jekyll2014/BTStation/docs/case_3d/image3.jpg

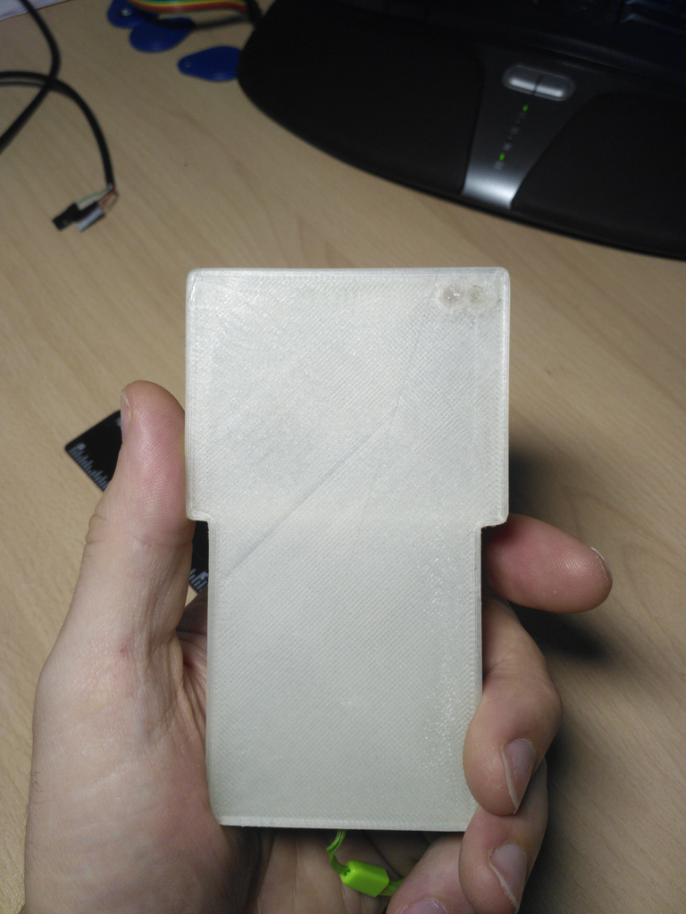
docs/case_3d/image3.jpg
