jekyll2014/BTStation/test_fw/README.md

Судейские Bluetooth станции электронной отметки для ММБ. [Исходная разработка](https://github.com/alexandervolikov/bt_station_mmb) - @alexandervolikov.

ТЗ на разработку судейских станций [здесь](docs/README.md).

Обычные станции без Bluetooth [здесь](https://github.com/alexandervolikov/sportiduino).
