jekyll2014/BTStation/docs/bluetooth/bt04-a/s01231336 (1).jpg

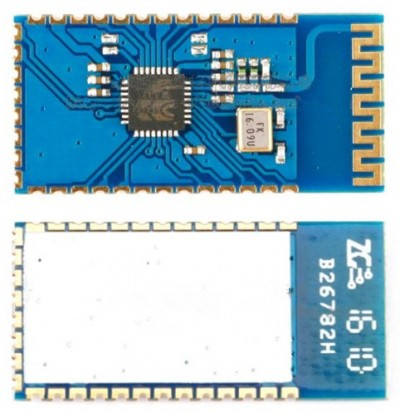
docs/bluetooth/bt04-a/s01231336 (1).jpg
