jekyll2014/BTStation/docs/bluetooth/bt04-a/s15476322.jpg

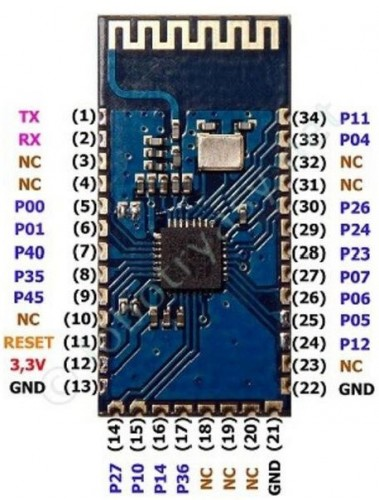
docs/bluetooth/bt04-a/s15476322.jpg
