jekyll2014/BTStation/docs/bluetooth/bt04-a/s88235175.jpg

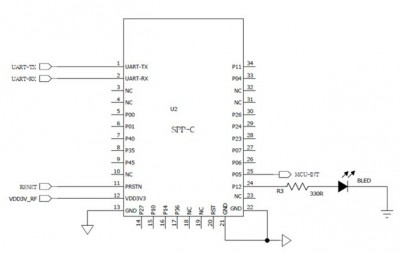
docs/bluetooth/bt04-a/s88235175.jpg
