jekyll2014/BTStation/docs/case_3d/image1.jpg

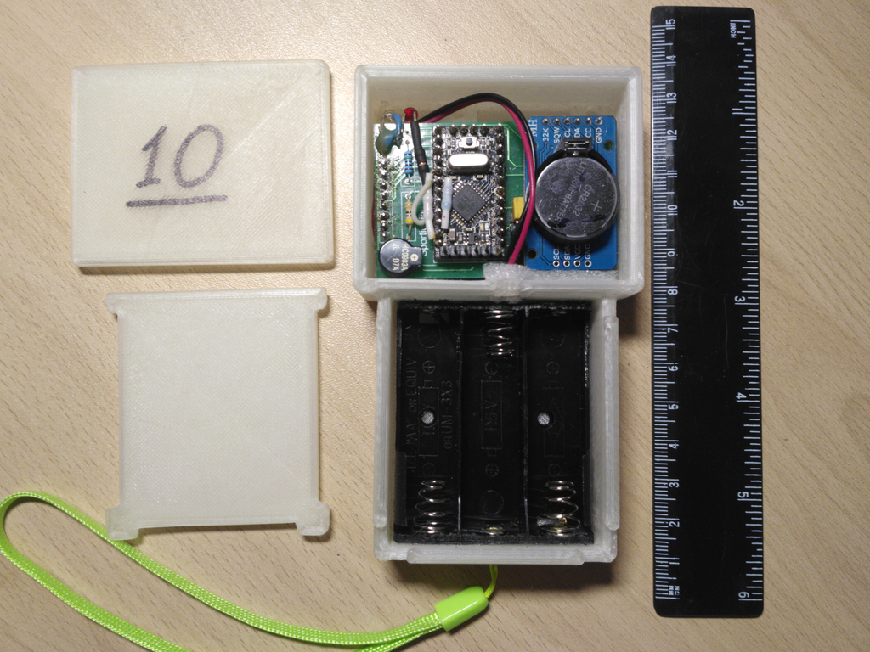
docs/case_3d/image1.jpg
