jekyll2014/BTStation/docs/case_3d/image2.jpg

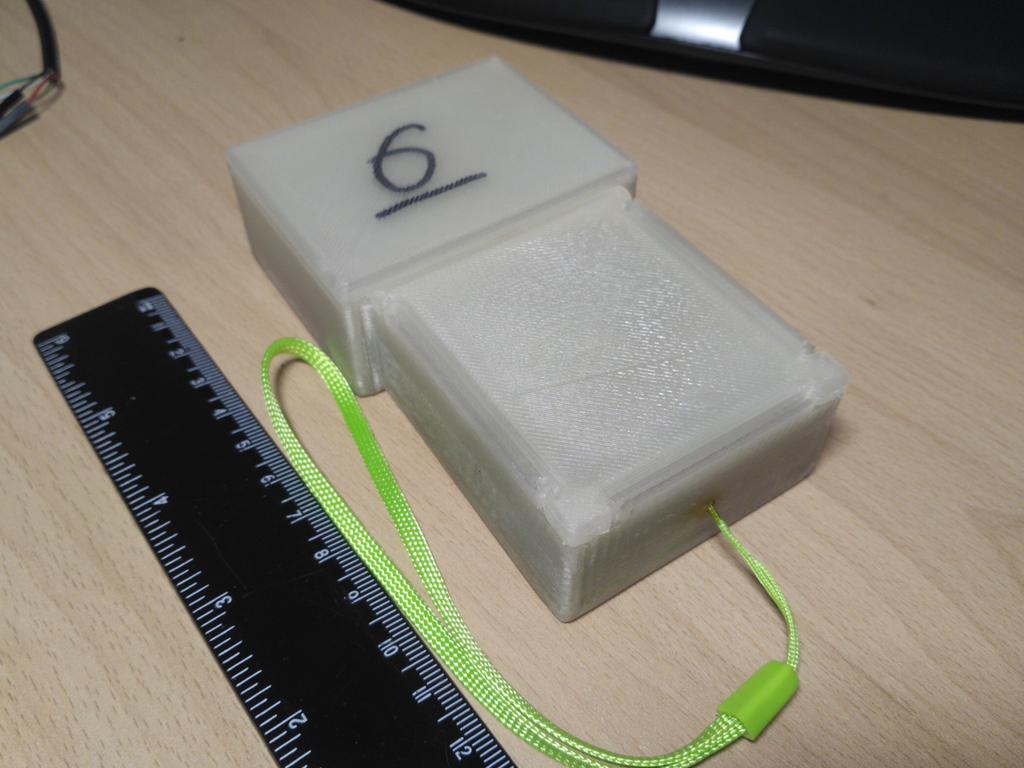
docs/case_3d/image2.jpg
