jekyll2014/BTStation/docs/case_3d/rfid_box_v3.jpg

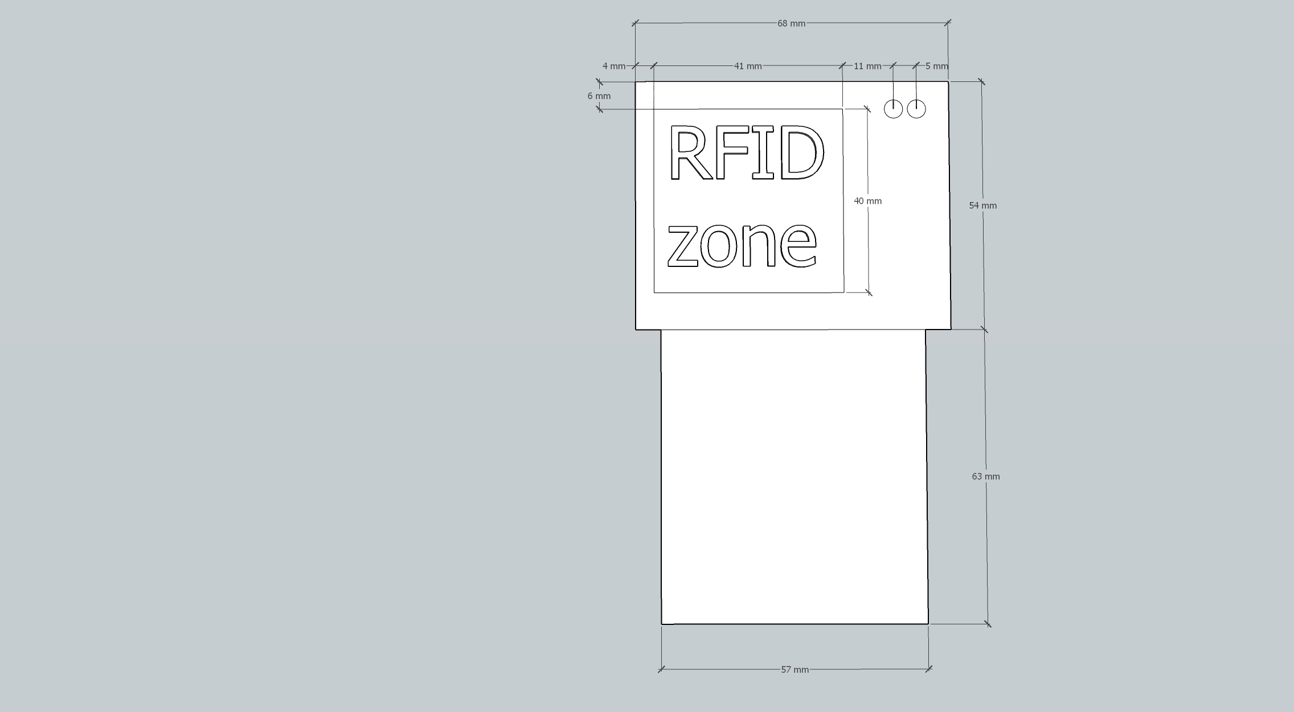
docs/case_3d/rfid_box_v3.jpg
