jekyll2014/BTStation/docs/rfid/RFID-RC522.png

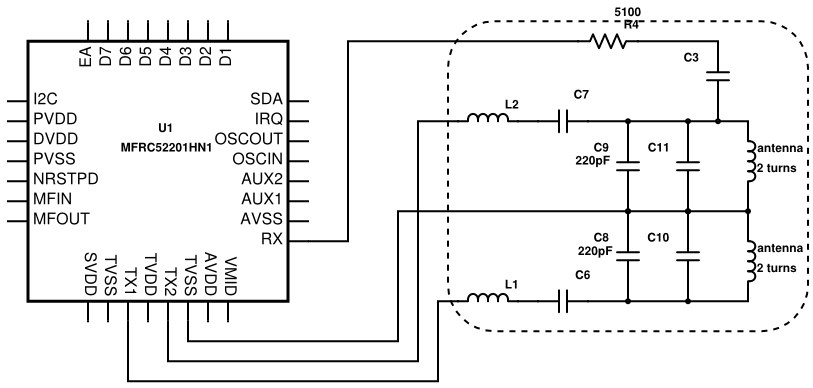
docs/rfid/RFID-RC522.png
