jekyll2014/BTStation/docs/case_3d/v3/rfid_box_v3-1_box.stl

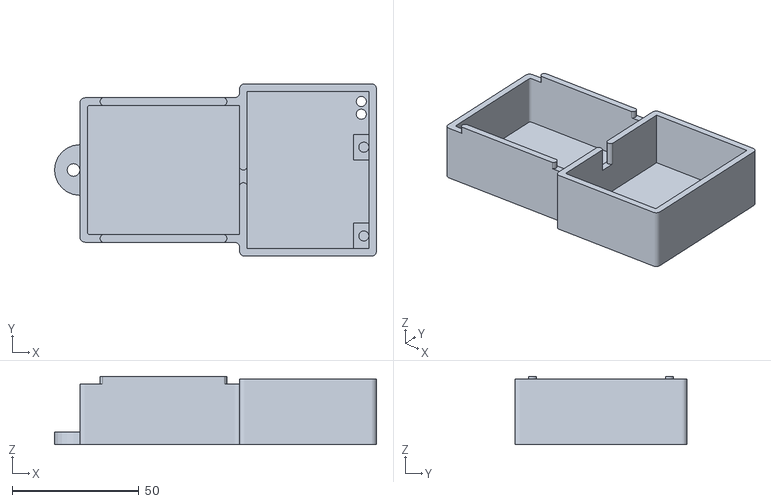
[picture p20: CAD file, 2020-05-06]
docs/case_3d/v3/rfid_box_v3-1_box.stl
127.0 x 68.0 x 27.0
