jekyll2014/BTStation/docs/case_3d/v3/rfid_box_v3-4_plug.stl

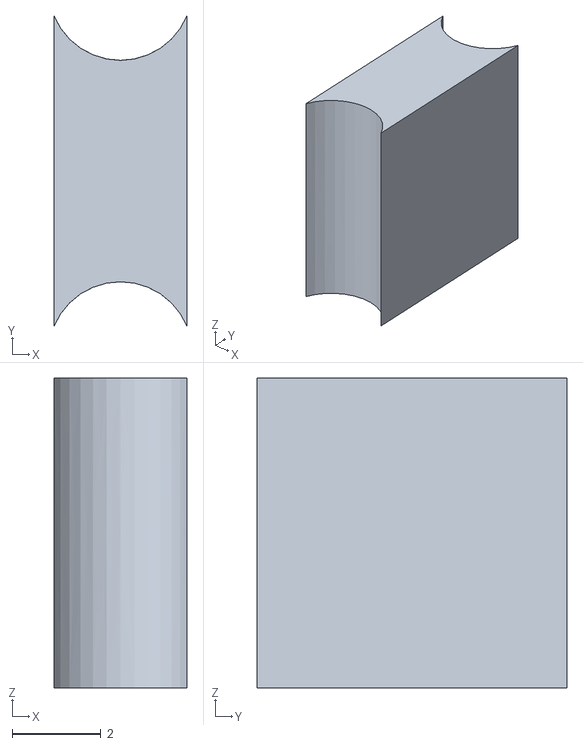
[picture p21: CAD file, 2020-05-06]
docs/case_3d/v3/rfid_box_v3-4_plug.stl
3.00 x 7.00 x 7.00
