jekyll2014/BTStation/docs/case_3d/v3/rfid_box_v3-3_battery.stl

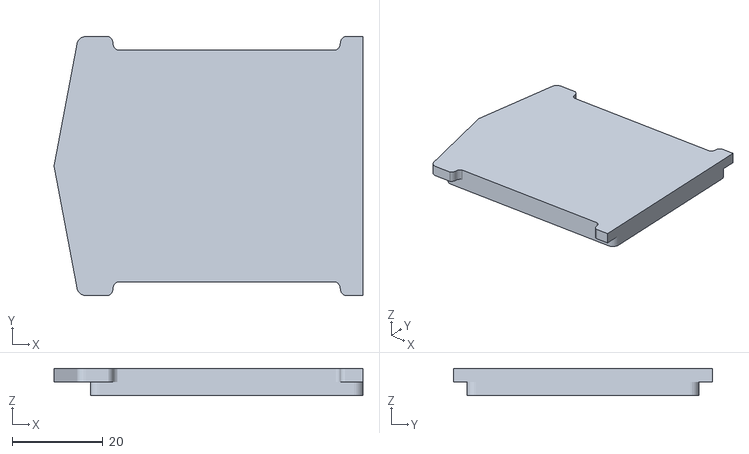
[picture p22: CAD file, 2020-05-06]
docs/case_3d/v3/rfid_box_v3-3_battery.stl
68.0 x 57.0 x 6.00
