jekyll2014/BTStation/docs/case_3d/v3/rfid_box_v3-2_rfid.stl

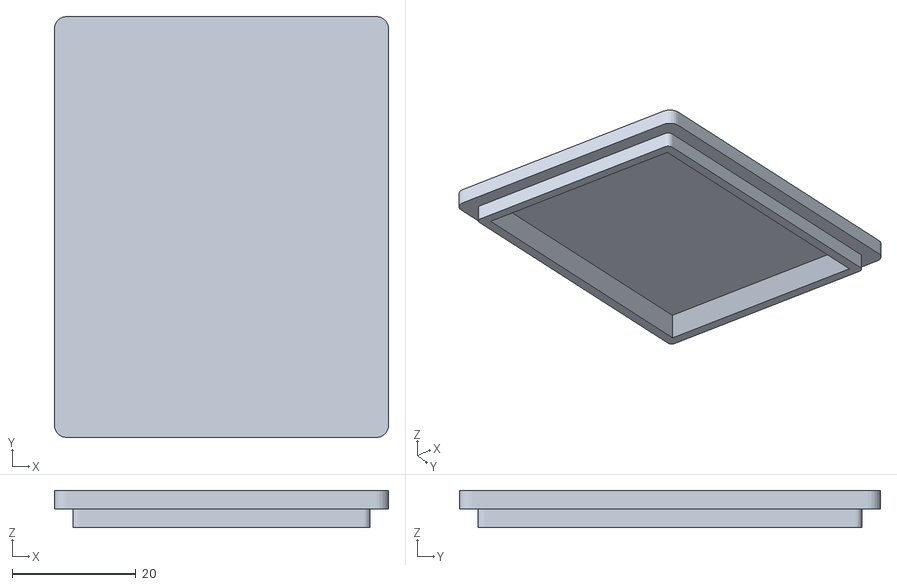
[picture p23: CAD file, 2020-05-06]
docs/case_3d/v3/rfid_box_v3-2_rfid.stl
54.0 x 68.0 x 6.00
