jekyll2014/BTStation/docs/case_3d/v1/rfid_box-3.stl

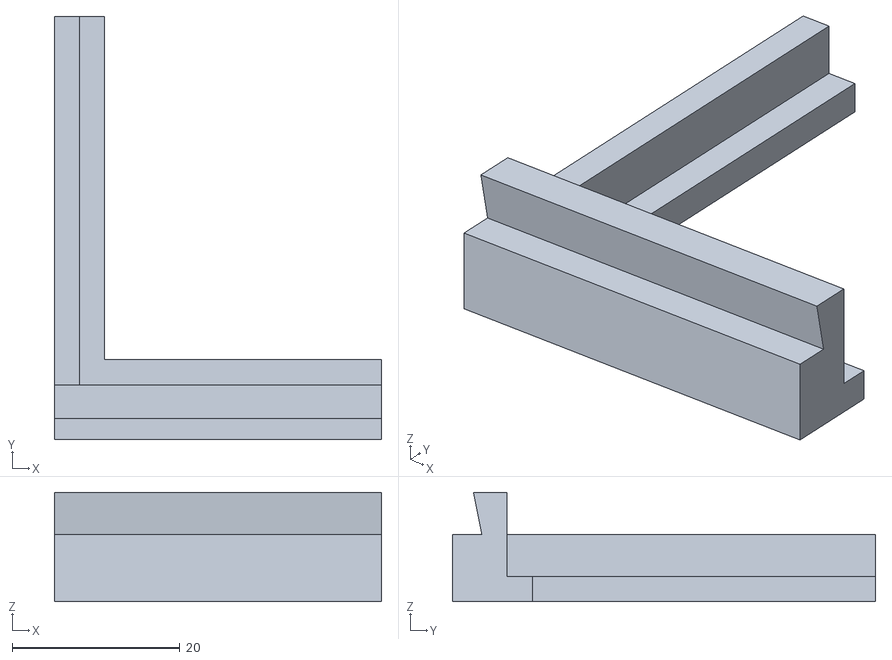
[picture p24: CAD file, 2020-05-06, an earlier design]
docs/case_3d/v1/rfid_box-3.stl
39.0 x 50.4 x 13.0
