jekyll2014/BTStation/docs/case_3d/v2/rfid_box_v2-1.stl

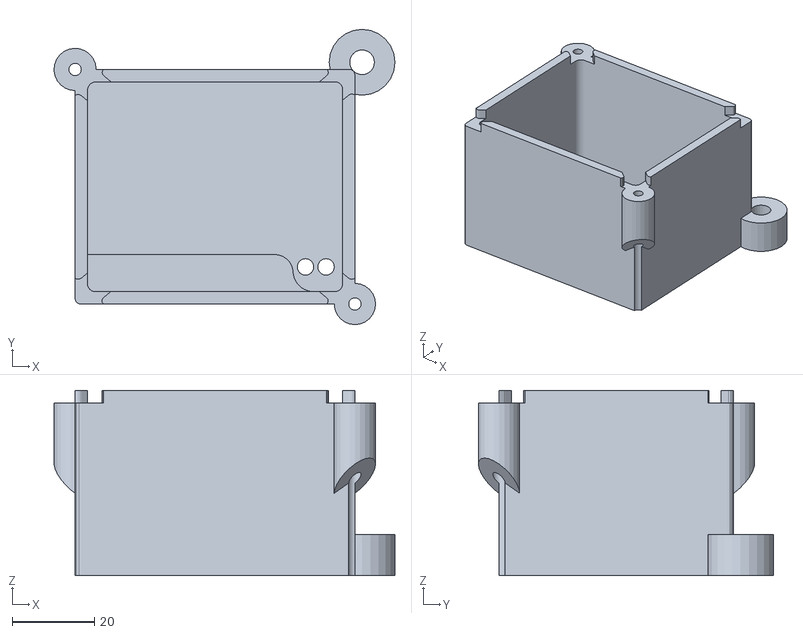
[picture p25: CAD file, 2020-05-06, an earlier design]
docs/case_3d/v2/rfid_box_v2-1.stl
82.9 x 71.8 x 45.0
