jekyll2014/BTStation/docs/case_3d/v1/rfid_box-2.stl

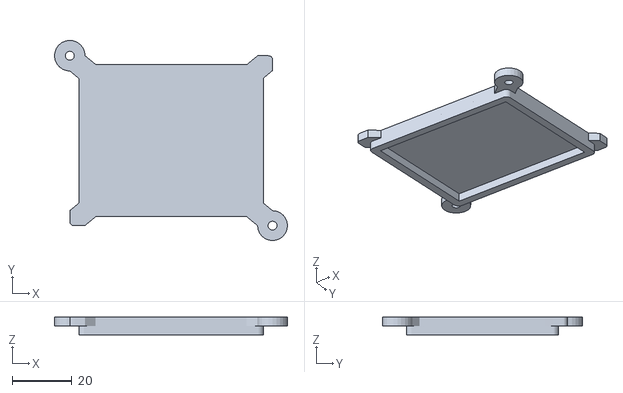
[picture p26: CAD file, 2020-05-06, an earlier design]
docs/case_3d/v1/rfid_box-2.stl
78.2 x 67.2 x 6.00
