jekyll2014/BTStation/docs/case_3d/v2/rfid_box_v2-2.stl

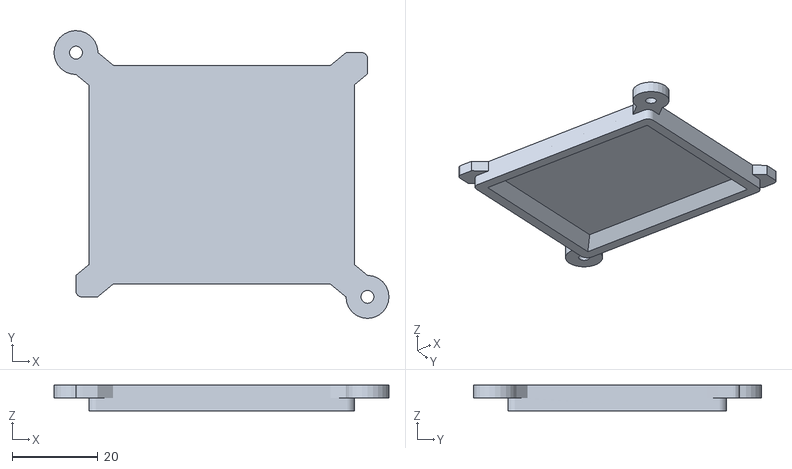
[picture p27: CAD file, 2020-05-06, an earlier design]
docs/case_3d/v2/rfid_box_v2-2.stl
78.2 x 67.2 x 6.00
