jekyll2014/BTStation/docs/case_3d/v1/rfid_box-1.stl

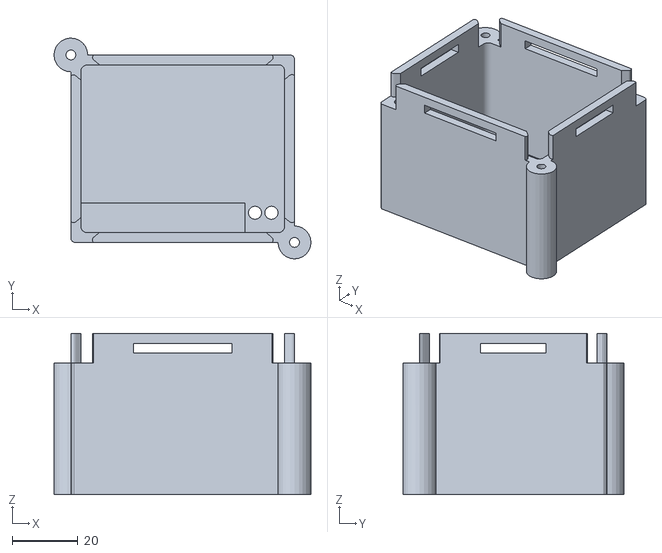
[picture p28: CAD file, 2020-05-06, an earlier design]
docs/case_3d/v1/rfid_box-1.stl
78.2 x 67.2 x 49.0
