jekyll2014/BTStation/(list of files, cad)

Other CAD files:
docs/case_3d/v2/rfid_box_v2-3.stl
docs/case_3d/v1/rfid_box.skp
docs/case_3d/v2/rfid_box_v2.skp
docs/case_3d/v3/rfid_box_v3.skp
