jekyll2014/BTStation/docs/issues.txt

To do:
fw	8) сделать бинарный поиск последнего занятого блока на карточке

+fw	1) доделать перезапись флэша для финишного режима.
+fw	2) в протокол ввести доп.параметр "ID запроса" (вместо 3-го 0xfe)
	- этот номер генерить при отправке команды и при отправке ответа станция будет этот номер оставлять в пакете.
+fw	3) поправить алгоритм смены маски команды (отметка схода участника)
	- новая маска хранится в памяти и обновляется при обработке карточки
	- после записи новой маски в карточку очищать буфер новой маски.
+fw	4) проверять версию прошивки при работе с чипами
+fw	5) запись в чип writeCardPage() разрешать только по UID
	- initChip() не требует UID, а возвращает его
+fw	6) предупреждать оператора о падении напряжения ниже критического (3.3V ?)
  	- мигать красным, пищать
+fw	7) продумать систему сигнализации об ошибках
	- синий светодиод горит во время работы с карточкой и показает по завершению.
  	- короткий писк (<0.5 сек.) раздается при окончании работы.
  	- любая ошибка - длинный писк 2 секунды + красный светодиод.
	- разделить ошибки на классы по типу оборудования:
		RFID - 1 сигнал
		Flash - 2 сигнала
		UART - 3 сигнала
		Прочее (EEPROM, логика) - 4 сигнала
+fw	- добавить команду установки блока стирания flash: setFlashBlockSize()
+fw	10) записывать на флэш блоками writeByteArray(). Читать флэш блоками readByteArray()
+fw	12) Для устранения постоянной отметки прислоненного чипа:
	- флаг с номером последней отмеченной команды устанавливать при отметке карточки или смене маски
	- флаг сбрасывать в 0 при ненахождении чипа в начале процедуры отметки
	- при флаге >0 не обрабатывать чип с номером как у флага.
+fw	13) выпилить из getConfig() параметр "8-11: размер сектора флэш-памяти" - бесполезен.
+fw	14) добавить команду установки имени Bluetooth адаптера
+fw	15) добавить команду установки пин-кода Bluetooth адаптера
+fw	16) проверить ошибку отметки с занесением в список отмеченных в памяти
+fw	17) Добавить команду SetBatteryLimit(float) для установки срабатывания сигнала о низком напряжении батареи.
+fw	18) Добавить значение минимального напряжения батареи в getConfig()
+sw	19) Для тестов читабельности чипов сделать софтину, чтобы автоматом стирала, писала, проверяла и старала опять. На все команды писать лог с временем исполнения и номером станции, чтобы потом понять:
		а) какие станции быстрее работают с чипом, в среднем (потенциально плохие)
		б) какие чипы в рамках одной станции читаются медленнее остальных (потенциально плохие)
		Наверное, не обязательно писать полный объем чипа - я не слышал про "полу-рабочие" чипы. Времени много сэкономим.
+sw	20) для теста флэша сделать софтину для записи/чтения всего флэша с фиксацией ошибок в логах.
+fw	21) сделать буфер последних ошибок и выдавать его в getStatus().
+fw	22) сделать команду int[] scanTeams(int startNumber) для сканирования памяти станции и выдачи списка сканированных команд

-fw	9) неудачная попытка отметки затирает дамп карточки команды.
	- Вариант - в режиме финишного КП записывать в буфер и обновлять основную запись только если не было ошибок.
-fw	23) плотнее покрыть код дебажными сообщениями и к сообщению прикладывать временную отметку
-fw	24) сделать диагностику flash-памяти
+fw	25) проверять ход внешних часов (DS3231) по ходу внутреннего счетчика и спрекращать работу, если внешние часы не идут (иногда попадаются глючные чипы)
-fw	26) реализовать возможность парольной защиты ячеек
