jekyll2014/BTStation/protocol_definitions.h

#pragma once
// описание протокола
#define HEADER_BYTE           0
#define PACKET_ID_BYTE        1
#define STATION_NUMBER_BYTE   2
#define COMMAND_BYTE          3
#define DATA_LENGTH_HIGH_BYTE 4
#define DATA_LENGTH_LOW_BYTE  5
#define DATA_START_BYTE       6

#define MAX_PAKET_LENGTH      255
