jekyll2014/BTStation/(commit log)

2020-05-06 Add project files.
    [rfid_box-1.stl, rfid_box-2.stl, rfid_box-3.stl, rfid_box.skp, rfid_box_v2-1.stl, rfid_box_v2-2.stl, rfid_box_v2-3.stl, rfid_box_v2.skp]
2020-09-27 minor fixes. Code beautification
    [BTStation-TEST.ino, command_definitions.h]
2024-08-31 Minor bugs fixed. Code refactored.
    [BTStation.ino]
2024-09-29 readFlash() fixed to return error. documentation fixed.
    [BTStation.ino]
2024-10-28 Error management improved. Hardware clock validation implemented.
    [BTStation.ino, command_definitions.h, error_codes.h, settings.h]
